dCSeven/HPGLPlotter/Documentation_and_PCBs/Pflichtenheft_v1.01.odt

Pflichtenheft HPGL Plotter

Version 1.01

Verteiler:

Name (alphab.)

Florian Dopona

Dokumentenverwaltung

Dokument-Historie

Version | Status | Datum | Verantwortlicher | Änderungsgrund
1 | Abgabe | 26.11.2013 | Florian Dopona | Erstellung
1.01 | | 21.05.2014 | Florian Dopona | Diplomarbeitsabgabe (Geringfügige Formatänderungen)

Änderungsberechtigte

Florian Dopona

Dokument wurde mit folgenden Tools erstellt:

LibreOffice 4.1

Inhaltsverzeichnis

# Allgemeine Beschreibung des Produkts

Es soll eine Ansteuerung für eine Fräse/Plotter erstellt werden, die dann mittels PC oder Handbedienung gesteuert werden kann.

## Zusammenhang mit bereits laufenden Projekten

Es bestehen keine Zusammenhänge mit laufenden Projekten.

## Zusammenhang mit Vorgänger- und Nachfolgeprojekten

Das Grundgerüst (Fräse ohne Elektronik und Motoren) wurde bereits von Herr Prof. Mayr gefertigt.

Ein Nachfolgeprojekt ist der Einbau meiner Elektronik mit geeigneten Schrittmotoren in das Gerüst von Herr Prof. Mayr.

Nach meiner Arbeit wäre es noch möglich die Fräse zu erweitern (zB USB / Ethernet / … , mehr Kommandos implementieren (Die Fräse wird nach meiner Arbeit nur ein Subset der Plottersprache HPGL beherrschen), oder aber den Interpreter um Sprachen erweitern (z.B die CNC-Standardsprache RS274/NGC(auch als G-Code bekannt) oder die Abwandlung Gerber (für 2D Fräsungen)).

## Zweck des Produkts

Der vorrangige Zweck der Fräse soll sein, zu zeigen, dass es, wenn auch mit etwas Arbeit, möglich ist, seine eigene Fräse zu bauen/anzusteuern.

Somit wird kein Wert auf die Geschwindigkeit und die Implementierung des gesamten HPGL Befehlssatzes gelegt.

## Abgrenzung und Einbettung des Produkts

Es wird vorausgesetzt, dass der zu verbindende PC eine serielle Schnittstelle hat und ein geeignetes Programm zur Übertragung sowie zur Erstellung des HPGL-Skriptes vorhanden ist.

Zudem ist es nicht Teil meines Projektes die von mir erstellte Elektronik in die bestehende Fräse einzubauen.

Es wird kein Werkzeugwechsel implementiert, dieser muss per Hand vorgenommen werden, da dafür die anzusteuernde Fräse nicht ausgelegt ist. Daher müssten Änderungen an der Werkzeugaufnahme durchgeführt sowie ein geeigneter Platz für die Werkzeuge geschaffen werden. Da meine Aufgabe jedoch nur die elektronische Ansteuerung ist, ist diese Funktion zu umfangreich.

Die Genauigkeit soll 1/40 mm (=0,025mm) betragen (Standard HPGL-Auflösung).

Es ist kein wesentlicher Teil des Projektes die „Druck“-Geschwindigkeit zu maximieren.

Aufgrund der HPGL bedingten ungenauen Steuerung in die Z-Achse (Befehle Pen up/Pen down) wird das eigentlich als Fräse (3-dimensional) gedachte Projekt in einen Plotter (2-dimensional) umgestaltet. Dies könnte in einem Folgeprojekt wieder erweitert werden.

Das Werkstück/Papier wird nicht automatisch ausgeworfen/eingezogen (HPGL-Befehl PG (Page Feed)), da es sich eigentlich um eine modifizierte Fräse handelt.

Zudem wird es mir aus zeitlichen Gründen nicht möglich sein, die Befehle für die Textausgabe zu implementieren. Alle nicht implementierten Befehle werden ignoriert.

Die Fräsen-/Plottersteuerung wird in der Fräse verbaut und kommuniziert dort via Serieller Schnittstelle mit dem PC.

## Überblick über die geforderte Funktionalität

Es soll ein Plotter erstellt werden, der vom PC aus über die serielle Schnittstelle die zu plottenden Daten in der Sprache HPGL bekommt. Diese sollen dann schrittweise abgearbeitet werden und

## Allgemeine Einschränkungen

Es werden als Mikrocontroller nur AVR-ATMEGA8,32 und 664 verwendet. Außerdem wird als Systemtakt ein Quarzoszillator mit 9,8304Mhz, für die Stromversorgung ein DC-Jack mit 5,5/2,1mm @12V benützt.

Für die Verbindung von externen Geräten kommen Steckverbinder mit 2,4,6,8,10,20 Polen, D-Sub Stecker mit 15,25 Kontakten oder RJ45 (8 polig) Stecksysteme in Frage.

Es dürfen SMD Bauteile verwendet werden.

## Vorgaben zu Hardware und Software

- In welcher HW-Umgebung soll das Zielsystem laufen?

Selbst erstelltes PCB mit AVR und je Achse einem TCA3727 zur Ansteuerung der Schrittmotoren

- In welcher SW-Umgebung soll das Zielsystem laufen?

Selbst geschriebener C- bzw. Assembler-Code

- In welcher HW-Umgebung soll das System entwickelt werden?

Es soll auf einem x64 PC entwickelt und mittels AVR-Doper im HID Modus programmiert werden.

- In welcher SW-Umgebung soll das System entwickelt werden (Betriebssysteme, Entwicklungstools, etc.)?

Entwicklung auf Gentoo Linux 3.10.7 amd64 mit Vim 7.3 und Kompilierung/Programmierung mittels Makefile unter Verwendung von avr-gcc 4.8.1, avr-libc, binutils und avrdude 5.11.1 eventuell auch noch avra 1.3 für Assembler-Sourcen.

## Benutzer des Produkts

Kenntnis der Kommunikation mit der seriellen Schnittstelle, eines geeigneten Programms, welches das Drucken über die serielle Schnittstelle mit HPGL ermöglicht

# Detaillierte Beschreibung der geforderten Produktmerkmale

## Lieferumfang

Plottersteuerungs-Modul

Dokumentation

## Abläufe (Szenarien) von Interaktionen mit der Umgebung

Drucken:

Plotter mit der seriellen Schnittstelle des PCs verbinden und Druckauftrag übermitteln.

Logischen Nullpunkt/Plotfenster setzen:

Mittels Handsteuerung des Plotters zum gewollten Punkt fahren und einen Knopf drücken.

Für das Plotfenster, außerhalb wird nichts ausgegeben, wird der Knopf auf beiden Positionen 2x gedrückt

Höhe für PenDown/PenUp bestimmen:

Auf Handsteuerung den Knopf für das Herunterlassen/Aufheben des Werkzeuges gedrückt halten und mittels Steuerkreuz Höhe einstellen.

Mit der Handsteuerung plotten:

Den Stift auf den Startpunkt begeben und mittels Knopfdruck hinunterlassen, Gewünschtes zeichnen und Stift wieder heben.

## Ziele des Benutzers

Das Hauptziel des Benutzers ist, eine Grafik (in Vektorform) auszudrucken, eine Torte zu verzieren oder dgl., abhängig vom verwendeten Werkzeug. Dazu müssen eventuell einige Einstellungen wie Höhe und Nullpunkt bestimmt werden.

## Geforderte Funktionen des Produkts

### Plotten über Serielle Verbindung

#### Wirkungsweise

Durch den PC werden die Daten (HPGL) über RS232 übermittelt, vom Plotter empfangen, zwischengespeichert und anschließend auf das Papier oder Ähnliches ausgegeben.

#### Abhängigkeiten / Randbedingungen

Das Plotten wird von der aktuellen Position aus durchgeführt und ist auf den definierten Bereich beschränkt.

### Erstinitialisierung

#### Wirkungsweise

Beim ersten Start werden die Endschalter eingelernt (in eine Richtung fahren bis er ausgelöst wird), dies Informationen werden im nicht volatilen EEPROM gespeichert um die Informationen über Neustartvorgänge zu sichern. Zum Schluss der Initialisierung wird die Mitte der Arbeitsfläche angefahren.

#### Abhängigkeiten / Randbedingungen

Bedingung dafür ist, dass die Informationen nicht im EEPROM vorhanden sind.

### Handsteuerung

#### Wirkungsweise

Hiermit lässt sich plotten, indem mittels Knopfdruck der Stift hinuntergelassen wird und die gewünschte Form mit dem Steuerkreuz gezeichnet wird.

Oder Steuerfunktionen durchführen:

Logischen Nullpunkt/Plotfenster setzen:

Stift zum gewünschten Punkt begeben und einen Knopf drücken um den logischen Nullpunkt festzulegen.

Für das Plotfenster wird der Knopf auf beiden Positionen 2x gedrückt.

Höhe für PenDown/PenUp bestimmen:

Auf Handsteuerung den Knopf für das Herunterlassen/Aufheben des Werkzeuges gedrückt halten und mittels Steuerkreuz Höhe einstellen.

Siehe 2.2.

## Externe Schnittstellen des Produkts

### Benutzerschnittstellen (User Interfaces)

Mein Produkt hat nur die Handsteuerung zur Eingabe von Daten und der Bewegung des Werkzeugs.

### Systemschnittstellen

#### Serielle Schnittstelle (RS-232)

- Daten werden unter Verwendung des HPGL Befehlssatzes übertragen
- Diese Daten werden unmittelbar interpretiert und ausgeführt
- Um einen Buffer-Overflow und deren Auswirkungen zu vermeiden, wird sobald der Empfangspuffer (softwaretechnisch realisiert) voll wird dem Gegenüber mithilfe des Hardware-Handshakes die Berechtigung Daten zu Senden entzogen.
- Es wird zur Übertragung ANSI EIA/TIA-232-F verwendet und mit einer Datenrate von 9.600 Baud gerechnet

#### I2C-Nunchuck

- Die Schnittstelle basiert auf einem I2C mit einem Pegel von 3.3 V und liefert die Daten wie im Anhang ersichtlich
- Diese Schnittstelle wird zur Interaktion mit dem Benutzer verwendet, und erlaubt es, die Fräse zu konfigurieren und steuern
- Das verwendete Übertragungsprotokoll ist I2C mit einer maximalen Übertragungsrate von 400kHz

## Sonstige geforderte Produktmerkmale

### Geschwindigkeitsmerkmale (Performance)

- Die Geschwindigkeit ist von der Geschwindigkeit der Motoren und der Übersetzung(Zahnräder/Riemen/...) abhängig, da diese jedoch nicht Bestandteil meines Projektes ist, werde ich nicht näher darauf eingehen.

### Ressourcenmerkmale (Resource)

- Es werden 1-2 Atmel-Mega Mikrocontroller (1MIPS) mit einer Frequenz von 9,8304MHz verwendet, diese dürfen vollkommen ausgelastet werden.
- Daten der zur Verwendung in Frage kommenden Controller:

– MEGA664: 64kB Programmspeicher, 4kB Arbeitsspeicher, 2kB EEPROM

– MEGA32 : 32kB Programmspeicher, 2kB Arbeitsspeicher, 1kB EEPROM

– MEGA8 : 8kB Programmspeicher, 1kB Arbeitsspeicher, 512B EEPROM

Die zu druckenden Daten werden jedoch sobald der dafür allozierte Bereich im Arbeitsspeicher des Controllers voll ist, in den Cache des Senders rückgestaut (Hardware-Handshake).

### Schutzmerkmale (Security)

Die Handsteuerung hat immer Priorität, wenn sie verwendet wird, wird die Abarbeitung der Befehle auf der seriellen Schnittstelle pausiert. Andere Merkmale sind nicht notwendig, da es nur diese beiden Interfaces geben wird.

### Sicherheitsmerkmale (Safety)

Endschalter sind als mechanischer Anschlag an jeder Achse vorhanden, wenn sie ausgelöst werden bleibt die Maschine stehen und der Fehler verursacht keine Schäden an der Hardware.

### Portabilitätsmerkmale (Portability)

Da dieses Projekt explizit für Atmel AVR-MEGA Mikrocontroller entwickelt wird, wird eine Portierung etwa auf Microchip PIC wegen der großen Unterschiede nicht leicht möglich werden.

Es wird jedoch mit geringerem Aufwand möglich sein auf einen anderen AVR umzusteigen, sofern dieser die nötige Leistung besitzt.

### Stabilitätsmerkmale (Reliability)

Dieses Verhalten ist kein ausschlaggebendes Kriterium, und wird deshalb nicht genauer überprüft und spezifiziert.

### Wartungsmerkmale (Maintenance)

Da das Produkt noch nicht entwickelt wurde, und dies kein ausschlaggebendes Erfolgskriterium ist, kann und werde ich darüber keine Angaben machen.

### Wiederverwendbarkeitsmerkmale (Reuse)

Der Interpreter soll erweiterbar gestaltet werden, um die nicht von mir implementierten Kommandos schnell ausprogrammieren zu können. Hiermit sollte es auch möglich werden eine andere Sprache zu unterstützen.

### Benutzbarkeitsmerkmale (Usability)

Nach der kurzen Einschulung sollten keine schwerwiegenden Probleme mit der Benutzung auftreten. Es könnte jedoch sein, dass Probleme mit den Software-Tools zur Übertragung des Druckauftrages per Serieller Schnittstelle auftreten.

### Umweltaspekte (Environment)

Die mittlere Leistungsaufnahme sollte bei 12V 60W nicht übersteigen.

NR: 3x1,5A Schrittmotoren 4,5A

100 mA Display 0,1A

3x45mA TCA3727 0,135A

<65 mA Mikrocontroller + Voltage Regulator + restliche Dinge (Pegelwandler, Handsteuerung)

Insgesamt maximal 4,8A --> 57,6W

# Vorgaben an die Projektabwicklung

## Anforderungen an die Realisierung

- Hardware

PC mit

>= 1 USB-Port für die Programmierung

>= 1 serielle Schnittstelle für die Kommunikation (Drucken)

Eventuell 1 2-Kanal DSO mit >20 MHz Bandbreite

- Software

Entwicklung auf Gentoo Linux mittels Editor Vim und avr-gcc als Compiler

Programmierung mittels avrdude

Verwendete Programmiersprachen sind C und Assembler

Es wird auf die Standard-AVR-Bibliothek zurückgegriffen

## Fertige und zugekaufte Komponenten

Bei aktuellem Entwicklungsstand sind noch keine Komponenten, außer der Handsteuerung bekannt, die zugekauft werden müssen oder von externen Quellen kommen.

Diese ist von Nintendo als Zubehör zur Nintendo Wii gedacht und wird als Nunchuck bezeichnet.

## Unterauftragnehmer

Es sind keine Unterauftragnehmer vorhanden.

## Abnahmebedingungen

- Rahmenbedingungen
  - Es wird gegen das Pflichtenheft im Zuge eines gemeinsamen Tests mit eigenen Testdaten in der Schule abgenommen

## Lieferbedingungen

Die Komponenten werden ausgedruckt und elektronisch (Source-Code sowie die flashfertige intel-hex Datei) übergeben

## Anforderungen an den Einsatz

Die Inbetriebnahme darf nur von Personen durchgeführt werden, die dazu imstande sind,d.h. von jemanden der das Gerät bedienen kann, eingeschult wurden.

## Gewährleistung

Es wird gewährleistet, dass die Hauptfunktionalität zur Zeit der Abnahme vorhanden ist.

# Verpflichtungen des Auftraggebers

- Der Auftraggeber ist dazu verpflichtet die notwendigen Komponenten zur Erstellung des Produktes in angemessener Zeit zur Verfügung zu stellen oder die Kosten für die Selbstbeschaffung von Komponenten zu tragen.

# Literaturverweise

http://wiibrew.org/wiki/Nunchuck , http://wiibrew.org/wiki/Wiimote/Extension_Controllers#The_New_Way für die Schnittstellendokumentation des Nintendo Wii Nunchucks im Anhang

http://cstep.luberth.com/HPGL.pdf für die Dokumentation des HPGL-Protokolls

# Anhang

## Schnittstellendokumentation Nintendo Wii Nunchuck

### Initialisierung

http://wiibrew.org/wiki/Wiimote/Extension_Controllers#The_New_Way

7-bit I2C address is 0x52

Controllers are mapped at register address 0xa40000.

The data is 0x100 bytes long, and it is mirrored across the entire 16-bit address space up to 0xa4FFFF. These registers are readable and writable. Communications are optionally encrypted.

The new way to initialize the extension is by writing 0x55 to 0x(4)A400F0, then writing 0x00 to 0x(4)A400FB. It works on all extensions, and makes the extension type bytes unencrypted.

Identification

Once initialized, the last six bytes of the register block identify the connected Extension Controller. A six-byte read of register 0xa400fa will return these bytes. The Extension Controller must have been initialized prior to this.

Decrypted | Meaning
0000 A420 0000 | Nunchuk (http://wiibrew.org/wiki/Wiimote/Extension_Controllers/Nunchuck)
0000 A420 0101 | Classic Controller (http://wiibrew.org/wiki/Wiimote/Extension_Controllers/Classic_Controller)
0100 A420 0101 | Classic Controller Pro (http://wiibrew.org/wiki/Wiimote/Extension_Controllers/Classic_Controller)

### Verwendung:

http://wiibrew.org/wiki/Nunchuck

The Nunchuk reports its information as 6 bytes of data, readable at 0xa40008 and streamable using Data Reporting Modes that include Extension bytes (unused bytes are filled with 0x00). The data is packed into the six bytes as follows (after decryption):

| Bit
Byte | 7 | 6 | 5 | 4 | 3 | 2 | 1 | 0
0 | SX<7:0>
1 | SY<7:0>
2 | AX<9:2>
3 | AY<9:2>
4 | AZ<9:2>
5 | AZ<1:0> | | AY<1:0> | | AX<1:0> | | BC | BZ

SX,SY are the Analog Stick X and Y positions, while AX, AY, and AZ are the 10-bit accelerometer data.

The values returned by the analog stick in the nunchuk enclosure do not encompass the full possible range, but rather have upper and lower bounds. These bounds seem to be in the same range across Nunchuks, but there is some variation. Analog stick X returns data from around 35 (fully left) to 228(fully right), while analog stick Y returns from around 27 to 220. Center for both is around 128.

BC and BZ are the state of the C and Z buttons (0=pressed).

## HPGL Befehlsreferenz

### Initialization and default setting instructions

Instruction Function

DF Default Set Instruction

IN Initialize Set Instruction

### Plot area and unit setting instructions

Instruction Function

IP Scaling point

SC Scale

IW Input window

RO Rotate coordinate system

PG Page output

### Pen Control and Plot Instructions

Instruction Function

PU Pen Up

PD Pen Down

PA Plot Absolute

PR Relative Coordinate Pen Move

AA Absolute Arc Plot

AR Relative Arc Plot

CI Circle

### The polygon group

Instruction Function

EA Edge Absolute Rectangle

ER Edge Relative Rectangle

EW Edge Wedge

RA Fill Absolute Rectangle

RR Fill Relative Rectangle

WG Fill Wedge

### Plot Function Instructions

Instruction Function

FT Fill Type

LT Line Type

PW Pen Width

SM Symbol Mode

SP Select Pen

TL Tick Length

XT X Tick

YT Y Tick

PT Pen Thickness

### Character Plot Instructions

Instruction Function

CS Standard Set Definition

CA Alternate Set Definition

SS Select Standard Font

SA Select Alternate Font

DT Define Label Terminator

LB Define Label

DI Absolute Direction

DR Relative Direction

CP Character Plot

SI Set Absolute Character Size

SR Set Relative Character Size

SL Set Character Slant

UC User-defined Character

### Dual Context Extensions

Instruction Function

EscCRRO Set HRC Off

EscCRRL Set HRC to Light Level

EscCRRM Set HRC to Medium Level

EscCRRD Set HRC to Dark Level

### User Reset

Instruction Function

EscCR!#R Restore to User Settings

### Factory Reset

Instruction Function

EscCRFD Restore to Factory Settings

HTBLA Traun Nur für den internen Gebrauch Ersteller: Prüfer: Name: Tel.: E-Mail: Florian Dopona <telefon> dopoflor@gmail.com Name: Tel.: E-Mail: <name> <telefon> <e-mail> Status: Gültig Datum: <datum>

Pflichtenheft HPGL Plotter V1.01 Seite 4 / 15

Pflichtenheft HPGL Plotter V1.01 Seite 15 / 15
