dCSeven/HPGLPlotter/Main/UART.c

#include "UART.h"

volatile char *txBuffer;
volatile char *txPtr; // used in ISR USART_UDRE to store position of currently transmitting character in txBuffer

volatile char *rxBuffer;
volatile char *rxPtr; // used in ISR USART_RXC the same way as txPtr in UDRE ISR


void USART_init_with_ubrr(unsigned int ubrr)
{
	// Set baud rate
	UBRRH = (unsigned char)(ubrr>>8)&0xFF;
	UBRRL = (unsigned char)ubrr&0xFF;
	// Enable receiver and transmitter
	UCSRB = (1<<RXEN)|(1<<TXEN);
	// Set frame format: 8data(UCSZx), 1stop bit(USBS) TODO check if it is right
	UCSRC = (1<<URSEL)|(0<<USBS)|((UART_BITS-5)<<UCSZ0);

	rxPtr=rxBuffer=(char *) malloc(RX_BUFFER_LENGTH);

	DDRD=(0<<PD0)|(1<<PD1);
#ifdef HARD_FLOW_CONTROL
	FLOW_DDR|=(0<<RTS)|(1<<CTS);
#endif
}

void USART_init()
{
	return USART_init_with_ubrr(MYUBRR);
}

void USART_transmit(char data) 
{
	//XXX clear UDRE interrupt before waiting (and set it to prev state after everything)
	// Wait for empty transmit buffer
	while ( !( UCSRA & (1<<UDRE)) );
	// Put data into buffer, which sends the data
	UDR = data;
	UCSRB|=(1<<TXEN);
}

// this function enables the DataRegisterEmpty-Interrupt
// to process the data there
void USART_transmit_string (char *data)
{
	UCSRB&=~(1<<UDRIE); // disable Interrupt (USART UDRE)
	if(txBuffer)free((void *)txBuffer); //FIXME don't free previous message
	txPtr=txBuffer=data;
	UCSRB|=(1<<UDRIE)|(1<<TXEN);
}

// receive 1 Byte (blocking)
char USART_receive(void)
{
	// Wait for data to be received
	if(!(UCSRB & (1<<RXEN)))UCSRB|=(1<<RXEN);
	while ( !(UCSRA & (1<<RXC)) );
	// Get status bits
	if(UCSRA & ((1<<PE)|(1<<DOR)|(1<<PE)))return -1;
	// Get and return received data from buffer
	return UDR;
}

// if enabled rxbuf will contain received data
void USART_enable_rx_interrrupt(void)
{
	UCSRB|=(1<<RXCIE);
}

void USART_disable_rx_interrupt(void)
{
	UCSRB&=~(1<<RXCIE);
}

//returns a copy of the received data and clears the rx buffer if it is not empty
char* USART_get_rx_buffer(void)
{
	int8_t len=rxPtr-rxBuffer;
	if(len>0)
	{
		cli();
		char * chr= (char*) malloc(len);
		*rxPtr='\0'; //Terminate String
		memcpy((void*)chr,(const char*)rxBuffer,len+1);

		//clear rx buffer
//		memset((void*)rxBuffer,0,len-1); // memset needed for string-termination 
		rxPtr=rxBuffer;
#ifdef HARD_FLOW_CONTROL
		FLOW_PORT|=(1<<CTS);
#elif defined SOFT_FLOW_CONTROL
#error SOFT_FLOW_CONTROL not implemented (USART_get_rx_buffer)
#else // NO FLOW CONTROL
		UCSRB|=(1<<RXCIE); // enable receiver again
#endif

		sei();
		return chr;
	}
	return 0;
}

/* USART Data Register Empty */
ISR(USART_UDRE_vect)	// maybe use USART_TXC_vect for verifying transmission
{
	if(txPtr && *txPtr!='\0') 
	{
		UDR=*txPtr++; 
	}
	else // Communication done 
	{
//		__asm__("cli UCRSB,UDRIE");
//		__asm__("cli UCRSB,TXEN");
//	UCSRB&=~((1<<UDRIE)|(1<<TXEN));
		UCSRB&=~(1<<UDRIE);
		
		free((void*)txBuffer);
		txPtr=txBuffer=0;
	}
}

/* USART, Rx Complete
 * maybe alter to split strings on \n*/
ISR(USART_RXC_vect)
{
	if(rxPtr && (rxPtr-rxBuffer)<(RX_BUFFER_LENGTH-2)) // if at least 2 fields are free
	{
		//TODO check error state
		*rxPtr=UDR;
		rxPtr++;
	}else if (rxPtr) // Buffer Overflow on next call
	{
		*rxPtr=UDR;
		rxPtr++;
#ifdef HARD_FLOW_CONTROL
		//TODO Hardware Handshaking 
		FLOW_PORT&=~(1<<CTS);

#elif defined SOFT_FLOW_CONTROL 
#error SOFT_FLOW_CONTROL not defined (ISR(USART_RXC_vect))
/*		if(txBuffer)
		{
			if(txPtr!=txBuffer)
			{
				*--txPtr=XOFF; // only if buffer not full
			}else
		}
		else
		{
			txBuffer=txPtr=(char *)malloc(2);
			*txBuffer=XOFF;
			*(txBuffer+1)='\0';
		}
*/	
		UCSRB|=(1<<UDRIE)|(1<<TXEN);
		//maybe clear interrupt too
#else // no flow control defined
		UCSRB&=~(1<<RXCIE); // clear interrupt to protect from buffer overflow (XXX find better solution)
#endif
		UCSRB&=~(1<<RXCIE);
	} else UCSRB&=~(1<<RXCIE);//else (no buffer available) probably clear Interrupt 
}

// vi :set ai ts=2 sw=2:
// vim:set ai ts=2 sw=2 fdm=syntax:
