dCSeven/HPGLPlotter/(commit log)

2014-01-20 Full upload (initial)
    [StepperTest.sch]
2014-01-21 Made master branch working again (further not working changes will be in testing branch)
    [main.c]
2014-02-05 Altered UART_Test/main.c
2014-02-06 Made UART library and included it in Main Project
2014-02-06 Updated Stepper functions and test progs to work interrupt driven Also made stuff in Main look more library like
    [StepperTest.sch]
2014-02-09 Made Stepper Library usable and updated makefile Also changed main.c (currently only a testing program for steppers)
2014-02-09 Updated TODOs in Stepper.h
2014-08-27 Added Documentation and PCBs
    (forgot that in END of Project Commit
    (2446b58cacf60955d77a6b0c98432f21c19aedc3))
